YuriyKostyuchenko/FLOW_MONITOR_DUAL_INDEPENDENT_RELAYS_v6.4/FLOW_MONITOR_DUAL_INDEPENDENT_RELAYS/FLOW_MONITOR_DUAL_INDEPENDENT_RELAYS.pdf

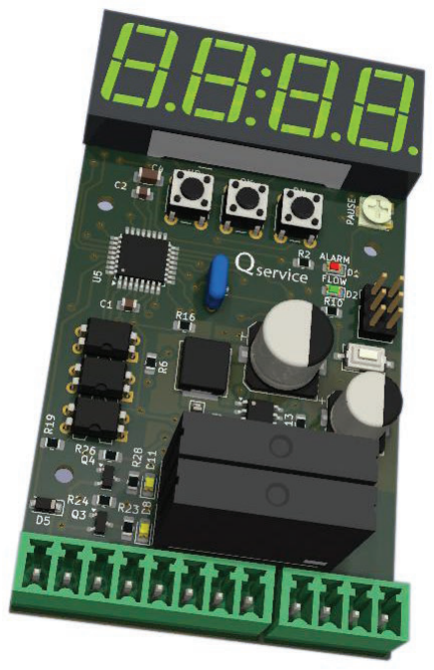
[picture p1: figure]

# FLOW MONITOR & DUAL INDEPENDENT RELAYS

v6.4

### Управление (Кнопки на приборе)

Кнопка | В рабочем режиме | В режиме меню
OK (удержание 2 сек) | Вход в сервисное меню | Выход в рабочий режим
OK (коротко) | Вход в параметр | Сохранение (надпись SAVE)
UP / DN | Выбор параметра | Изменение значения

### Таблица параметров (Меню)

Функция | Диапазон | Описание
P1 Калибровка | 0 — 9999 | Импульсов/литр. (значение из руководства датчика)
При 0 — вывод импульсов в сек.
P2 Мин. поток | 0 — 9999 | Порог срабатывания аварии.
При P1 = 0 количество импульсов. При P1 > 0 литров в минуту.
P3 Стабилизация | 1 — 255 сек | Время игнорирование потока
после подачи сигнала на EN.
P4 Режим (реле 1) | 0 — 4 | Алгоритм работы реле 1.
Режим 0: Прямой
Реле активно, пока на входе присутствует активный сигнал. Сигнал пропал — реле выключилось. Режим 1: Триггерный
Реле меняет состояние (ВКЛ/ВЫКЛ) по каждому переднему фронту сигнала (переход из 1 в 0). Режим 2: Одиночный импульс (Таймер)
При появлении сигнала реле включается на время А. Повторные сигналы во время работы игнорируются. Для перезапуска сигнал должен пропасть и появиться снова.
Режим 3: Цикл
Цикл «Работа А / Пауза Б» выполняется только при наличии активного сигнала на входе. Как только сигнал снимается реле мгновенно отключается,
а цикл сбрасывается.
Режим 4: Отложенный старт
При появлении сигнала запускается таймер паузы Б, после чего реле включается на время А.
Цикл отрабатывается полностью (one-shot), независимо от того, остался ли входной сигнал активным.
P5 Время А (реле 1) | 0 — 9999 сек | Время работы или основной интервал.
P6 Время B (реле 1) | 0 — 9999 сек | Время паузы или отложенного старта.
P7 Режим (реле 2) | 0 — 4 | Алгоритм работы реле 2.
Режим 0: Прямой
Реле активно, пока на входе присутствует активный сигнал. Сигнал пропал — реле выключилось. Режим 1: Триггерный
Реле меняет состояние (ВКЛ/ВЫКЛ) по каждому переднему фронту сигнала (переход из 1 в 0). Режим 2: Одиночный импульс (Таймер)
При появлении сигнала реле включается на время А. Повторные сигналы во время работы игнорируются.

Äëÿ ïåðåçàïóñêà ñèãíàë äîëæåí ïðîïàñòü è ïîÿâèòüñÿ ñíîâà.

### Ðåæèì 3: Öèêë

Öèêë «Ðàáîòà À / Ïàóçà Á» âûïîëíÿåòñÿ òîëüêî ïðè íàëè÷èè àêòèâíîãî ñèãíàëà íà âõîäå. Êàê òîëüêî ñèãíàë ñíèìàåòñÿ ðåëå ìãíîâåííî îòêëþ÷àåòñÿ,
à öèêë ñáðàñûâàåòñÿ.

### Ðåæèì 4: Îòëîæåííûé ñòàðò

Ïðè ïîÿâëåíèè ñèãíàëà çàïóñêàåòñÿ òàéìåð ïàóçû Á, ïîñëå ÷åãî ðåëå âêëþ÷àåòñÿ íà âðåìÿ À.
Öèêë îòðàáàòûâàåòñÿ ïîëíîñòüþ (one-shot), íåçàâèñèìî îò òîãî, îñòàëñÿ ëè âõîäíîé ñèãíàë àêòèâíûì.
P8 Âðåìÿ À (ðåëå 2) | 0 — 9999 ñåê | Âðåìÿ ðàáîòû èëè îñíîâíîé èíòåðâàë.
P9 Âðåìÿ B (ðåëå 1) | 0 — 9999 ñåê | Âðåìÿ ïàóçû èëè îòëîæåííîãî ñòàðòà.
P10 ßðêîñòü | 1 — 7 | Èíòåíñèâíîñòü ñâå÷åíèÿ äèñïëåÿ.

## Ëîãèêà ðàáîòû ðåëå (Âõîäû IN_1, IN_2)

Ñèãíàëû ñ÷èòàþòñÿ àêòèâíûìè ïðè ëîãè÷åñêîì «0» (çàìûêàíèå âõîäà íà GND).

### Ðåæèì 0: Ïðÿìîé

Ðåëå àêòèâíî, ïîêà íà âõîäå ïðèñóòñòâóåò àêòèâíûé ñèãíàë. Ñèãíàë ïðîïàë — ðåëå âûêëþ÷èëîñü.

### Ðåæèì 1: Òðèããåðíûé

Ðåëå ìåíÿåò ñîñòîÿíèå (ÂÊË/ÂÛÊË) ïî êàæäîìó ïåðåäíåìó ôðîíòó ñèãíàëà (ïåðåõîä èç 1 â 0).

### Ðåæèì 2: Îäèíî÷íûé èìïóëüñ (Òàéìåð)

Ïðè ïîÿâëåíèè ñèãíàëà ðåëå âêëþ÷àåòñÿ íà âðåìÿ À.
Ïîâòîðíûå ñèãíàëû âî âðåìÿ ðàáîòû èãíîðèðóþòñÿ.
Äëÿ ïåðåçàïóñêà ñèãíàë äîëæåí ïðîïàñòü è ïîÿâèòüñÿ ñíîâà.

### Ðåæèì 3: Öèêë

Öèêë «Ðàáîòà À / Ïàóçà Á» âûïîëíÿåòñÿ òîëüêî ïðè íàëè÷èè àêòèâíîãî ñèãíàëà íà âõîäå. Êàê òîëüêî CNC ñíèìàåò ñèãíàë, ðåëå ìãíîâåííî îòêëþ÷àåòñÿ, à öèêë ñáðàñûâàåòñÿ.

### Ðåæèì 4: Îòëîæåííûé ñòàðò

Ïðè ïîÿâëåíèè ñèãíàëà çàïóñêàåòñÿ òàéìåð ïàóçû Á, ïîñëå ÷åãî ðåëå âêëþ÷àåòñÿ íà âðåìÿ À. Öèêë îòðàáàòûâàåòñÿ ïîëíîñòüþ (one-shot), íåçàâèñèìî îò òîãî, îñòàëñÿ ëè âõîäíîé ñèãíàë àêòèâíûì.

## Êîíòðîëü ïîòîêà è Àâàðèÿ

Êîíòðîëü çàâÿçàí íà âõîä EN (ñèãíàë ãîòîâíîñòè ñèñòåìû èëè âêëþ÷åíèÿ øïèíäåëÿ/íàñîñà ñ CNC). Çàïóñê: ïðè ïîÿâëåíèè àêòèâíîãî ñèãíàëà íà EN.
Çàäåðæêà (P3): Îæèäàíèå âûõîäà ñèñòåìû íà ðàáî÷èé ðåæèì.
Ìîíèòîðèíã: åñëè ÷åðåç P3 ñåê ïîòîê íèæå P2:
Àêòèâèðóåòñÿ âûõîä ALARM_OUT (Ïèí A3).
Çàãîðàåòñÿ êðàñíûé LED, ãàñíåò çåëåíûé.
Ñáðîñ: ïðè ñíÿòèè ñèãíàëà ñ EN ñîñòîÿíèå àâàðèè ìãíîâåííî ñáðàñûâàåòñÿ.

## Ñîõðàíåíèå â ïàìÿòü (EEPROM)

×òîáû äàííûå íå îáíóëèëèñü:
Â ðåæèìå ðåäàêòèðîâàíèÿ óñòàíîâèòå çíà÷åíèå. Íàæìèòå êîðîòêî OK.
Äîæäèòåñü ïîÿâëåíèÿ íàäïèñè SAVE.
