YuriyKostyuchenko/FLOW_MONITOR_DUAL_INDEPENDENT_RELAYS_v6.4/FLOW_MONITOR_DUAL_INDEPENDENT_RELAYS/FLOW_MONITOR_DUAL_INDEPENDENT_RELAYS.kicad_pcb

## KiCad design FLOW_MONITOR_DUAL_INDEPENDENT_RELAYS/FLOW_MONITOR_DUAL_INDEPENDENT_RELAYS.kicad_pcb (2026-01-07)

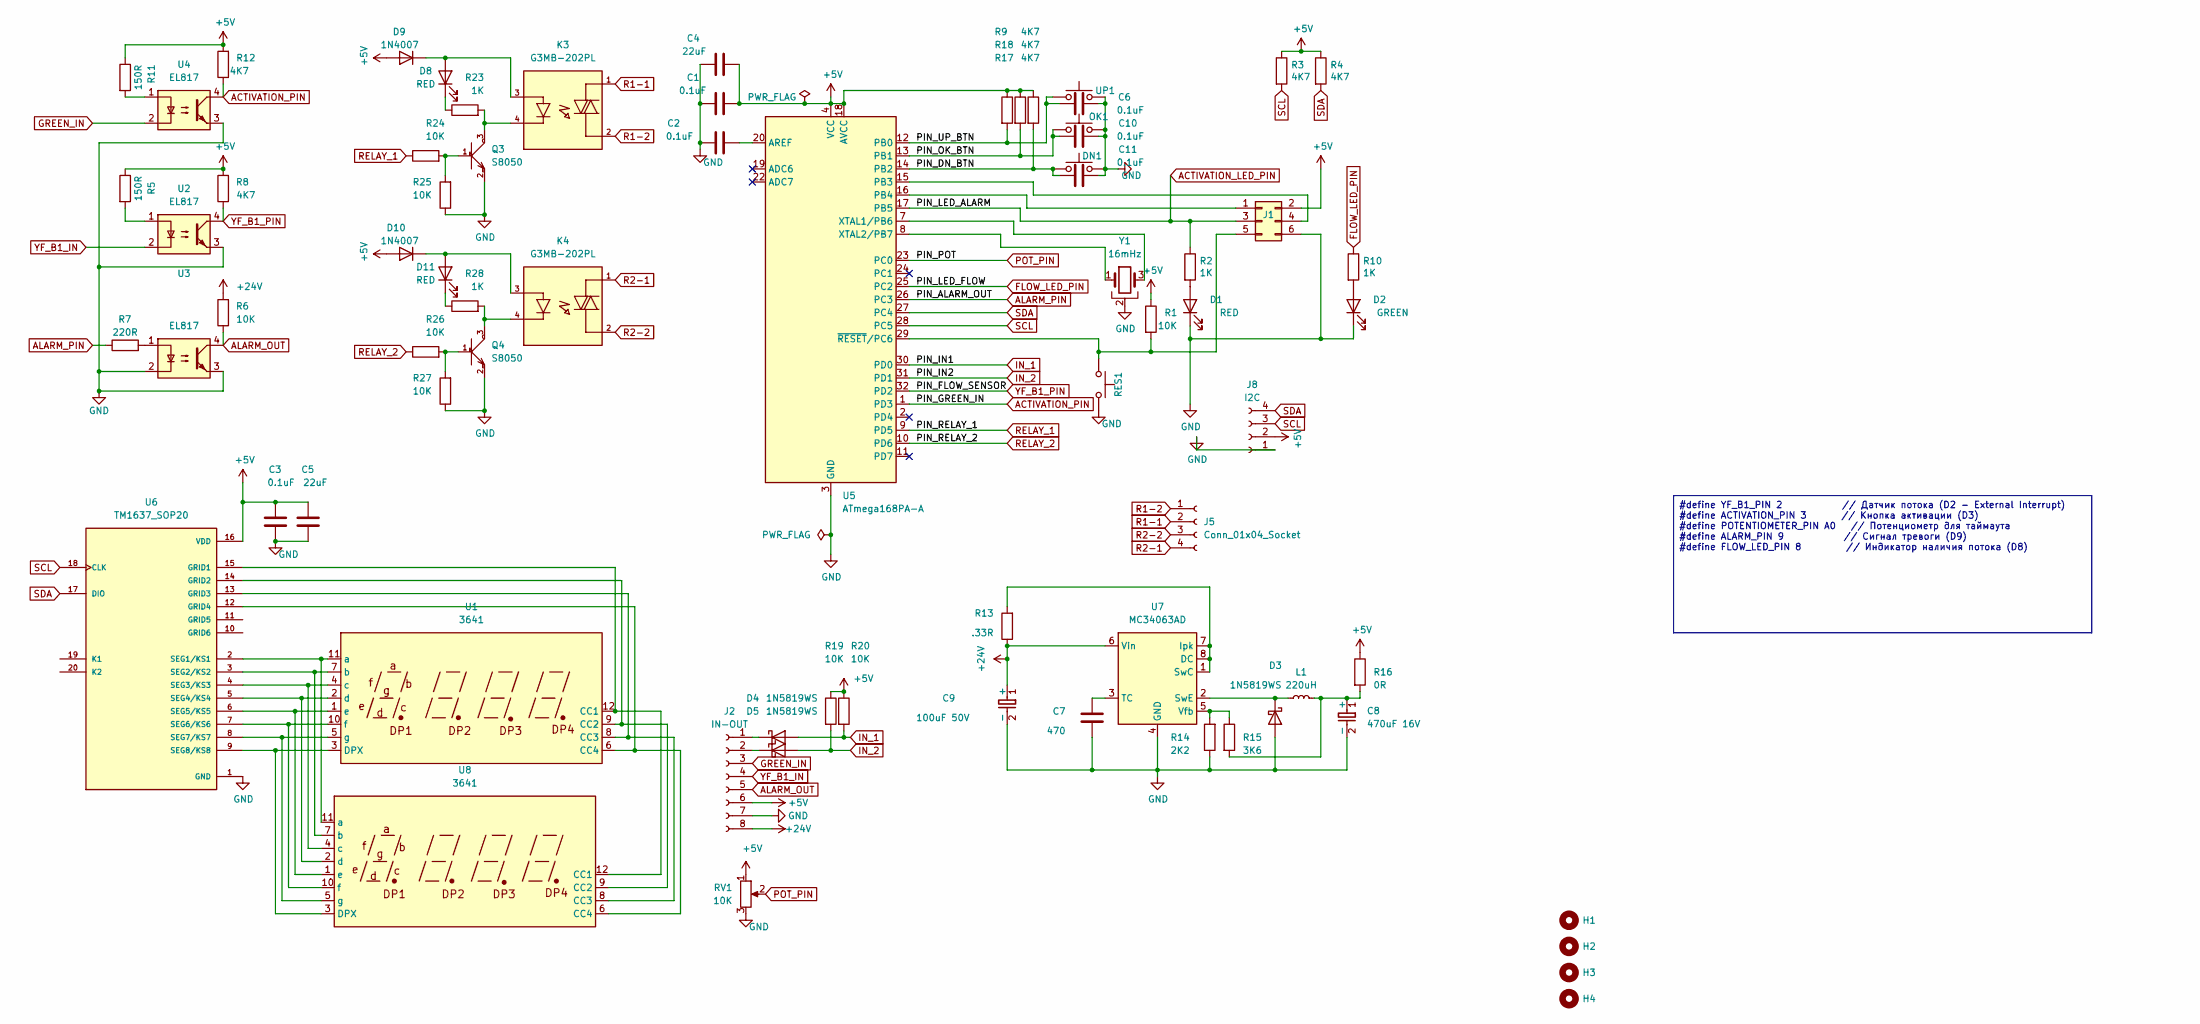
[picture p2: schematic FLOW_MONITOR_DUAL_INDEPENDENT_RELAYS.kicad_sch]

Parts:
C1, C2, C3, C6, C10, C11: 0.1uF; C_0805_2012Metric_Pad1.18x1.45mm_HandSolder
C4: 22uF; C_1206_3216Metric_Pad1.33x1.80mm_HandSolder
C5: 22uF; C_0805_2012Metric_Pad1.18x1.45mm_HandSolder
C7: 470; C_0805_2012Metric_Pad1.18x1.45mm_HandSolder
C8: 470uF 16V; CP_Elec_10x10.5
C9: 100uF 50V; CP_Elec_8x10
D1, D8, D11: RED; LED_0805_2012Metric_Pad1.15x1.40mm_HandSolder
D2: GREEN; LED_0805_2012Metric_Pad1.15x1.40mm_HandSolder
D3, D4, D5: 1N5819WS; D_SOD-123
D9, D10: 1N4007; D_SMA
DN1: SW_Push; SW_PUSH_6mm
H1, H2, H3, H4: MountingHole; MountingHole_2.5mm
J1: Conn_02x03_Top_Bottom; PinHeader_2x03_P2.54mm_Vertical
J2: IN-OUT; PhoenixContact_MCV_1,5_8-G-3.81_1x08_P3.81mm_Vertical
J5: Conn_01x04_Socket; PhoenixContact_MCV_1,5_4-G-3.81_1x04_P3.81mm_Vertical
J8: I2C; OLED_LCD_128x32
K3, K4: G3MB-202PL; RELAY_G3MB-202PL; PARTREV 06/09
L1: 220uH; L_7.3x7.3_!!!!!!!
OK1: SW_Push; SW_PUSH_6mm
Q3, Q4: S8050; SOT-23; MPN S8050
R1, R6, R19, R20, R24, R25, R26, R27: 10K; R_0805_2012Metric_Pad1.20x1.40mm_HandSolder
R2, R10, R23, R28: 1K; R_0805_2012Metric_Pad1.20x1.40mm_HandSolder
R3, R4, R8, R9, R12, R17, R18: 4K7; R_0805_2012Metric_Pad1.20x1.40mm_HandSolder
R5, R11: 150R; R_0805_2012Metric_Pad1.20x1.40mm_HandSolder
R7: 220R; R_0805_2012Metric_Pad1.20x1.40mm_HandSolder
R13: .33R; R_0805_2012Metric_Pad1.20x1.40mm_HandSolder
R14: 2K2; R_0805_2012Metric_Pad1.20x1.40mm_HandSolder
R15: 3K6; R_0805_2012Metric_Pad1.20x1.40mm_HandSolder
R16: 0R; R_0805_2012Metric_Pad1.20x1.40mm_HandSolder
RES1: SW_Push; SW_Tactile_SPST_NO_Straight_CK_PTS636Sx25SMTRLFS
RV1: 10K; Potentiometer_Bourns_3314J_Vertical
U1: 3641; 3631
U2, U3, U4: EL817; DIP-4_W7.62mm
U5: ATmega168PA-A; TQFP-32_7x7mm_P0.8mm
U6: TM1637_SOP20; SOIC127P1035X255-20N; PARTREV V2.6
U7: MC34063AD; SOIC-8_3.9x4.9mm_P1.27mm
U8: 3641; CC56-12GWA
UP1: SW_Push; SW_PUSH_6mm
Y1: 16mHz; XTAL_ZTT-4.00MG

Connections:
+5V: C1.2, C3.2, C4.2, C5.2, D9.2 (A), D10.2 (A), J1.2, J2.6, J8.2, R1.1, R3.1, R4.1, R5.1, R8.2, R9.1, R11.1, R12.2, R16.1, R17.1, R18.1, R19.1, R20.1, RV1.1, U5.4 (VCC), U5.6 (VCC), U5.18 (AVCC), U6.16 (VDD)
+24V: C9.1 (+), J2.8, R6.2, R13.1, U7.6 (Vin)
ACTIVATION_LED_PIN: J1.3, R2.1, U5.17 (PB5)
ACTIVATION_PIN: R12.1, U4.4, U5.1 (PD3)
ALARM_OUT: J2.5, R6.1, U3.4
ALARM_PIN: R7.1, U5.26 (PC3)
FLOW_LED_PIN: R10.1, U5.25 (PC2)
GND: C1.1, C2.1, C3.1, C4.1, C5.1, C6.2, C7.1, C8.2 (-), C9.2 (-), C10.2, C11.2, D1.1 (K), D2.1 (K), D3.2 (A), DN1.2, J1.6, J2.7, J8.1, OK1.2, Q3.2, Q4.2, R14.1, R25.1, R27.1, RES1.2, RV1.3, U2.3, U3.2, U3.3, U4.3, U5.3 (GND), U5.5 (GND), U5.21 (GND), U6.1 (GND), U7.4 (GND), UP1.2, Y1.2
GREEN_IN: J2.3, U4.2
IN_1: D4.2 (A), R20.2, U5.30 (PD0)
IN_2: D5.2 (A), R19.2, U5.31 (PD1)
unnamed: C8.1 (+), L1.2, R15.2, R16.2
unnamed: D1.2 (A), R2.2
unnamed: D2.2 (A), R10.2
unnamed: D3.1 (K), L1.1, U7.2 (SwE)
unnamed: D4.1 (K), J2.1
unnamed: D5.1 (K), J2.2
unnamed: D8.2 (A), D9.1 (K), K3.3
unnamed: D8.1 (K), R23.1
unnamed: D10.1 (K), D11.2 (A), K4.3
unnamed: D11.1 (K), R28.1
unnamed: J1.1, U5.16 (PB4)
unnamed: J1.4, U5.15 (PB3)
unnamed: J1.5, R1.2, RES1.1, U5.29 (~RESET/PC6)
unnamed: K3.4, Q3.3, R23.2
unnamed: K4.4, Q4.3, R28.2
unnamed: Q3.1, R24.2, R25.2
unnamed: Q4.1, R26.2, R27.2
unnamed: R5.2, U2.1
unnamed: R7.2, U3.1
unnamed: R11.2, U4.1
unnamed: U1.12 (CC1), U6.15 (GRID1), U8.12 (CC1)
unnamed: U1.9 (CC2), U6.14 (GRID2), U8.9 (CC2)
unnamed: U1.8 (CC3), U6.13 (GRID3), U8.8 (CC3)
unnamed: U1.6 (CC4), U6.12 (GRID4), U8.6 (CC4)
unnamed: U1.3 (DPX), U6.9 (SEG8/KS8), U8.3 (DPX)
unnamed: U1.11 (a), U6.2 (SEG1/KS1), U8.11 (a)
unnamed: U1.7 (b), U6.3 (SEG2/KS2), U8.7 (b)
unnamed: U1.4 (c), U6.4 (SEG3/KS3), U8.4 (c)
unnamed: U1.2 (d), U6.5 (SEG4/KS4), U8.2 (d)
unnamed: U1.1 (e), U6.6 (SEG5/KS5), U8.1 (e)
unnamed: U1.10 (f), U6.7 (SEG6/KS6), U8.10 (f)
unnamed: U1.5 (g), U6.8 (SEG7/KS7), U8.5 (g)
unnamed: C2.2, U5.20 (AREF)
unnamed: C6.1, R9.2, U5.12 (PB0), UP1.1
unnamed: C10.1, OK1.1, R17.2, U5.13 (PB1)
unnamed: C11.1, DN1.1, R18.2, U5.14 (PB2)
unnamed: U5.7 (XTAL1/PB6), Y1.3
unnamed: U5.8 (XTAL2/PB7), Y1.1
unnamed: R13.2, U7.1 (SwC), U7.7 (Ipk), U7.8 (DC)
unnamed: C7.2, U7.3 (TC)
unnamed: R14.2, R15.1, U7.5 (Vfb)
POT_PIN: RV1.2, U5.23 (PC0)
R1-1: J5.2, K3.1
R1-2: J5.1, K3.2
R2-1: J5.4, K4.1
R2-2: J5.3, K4.2
RELAY_1: R24.1, U5.9 (PD5)
RELAY_2: R26.1, U5.10 (PD6)
SCL: J8.3, R3.2, U5.28 (PC5), U6.18 (CLK)
SDA: J8.4, R4.2, U5.27 (PC4), U6.17 (DIO)
YF_B1_IN: J2.4, U2.2
YF_B1_PIN: R8.1, U2.4, U5.32 (PD2)

Notes on the sheet:
#define YF_B1_PIN 2 // Датчик потока (D2 - External Interrupt) #define ACTIVATION_PIN 3 // Кнопка активации (D3) #define POTENTIOMETER_PIN A0 // Потенциометр для таймаута #define ALARM_PIN 9 // Сигнал тревоги (D9) #define FLOW_LED_PIN 8 // Индикатор наличия потока (D8)

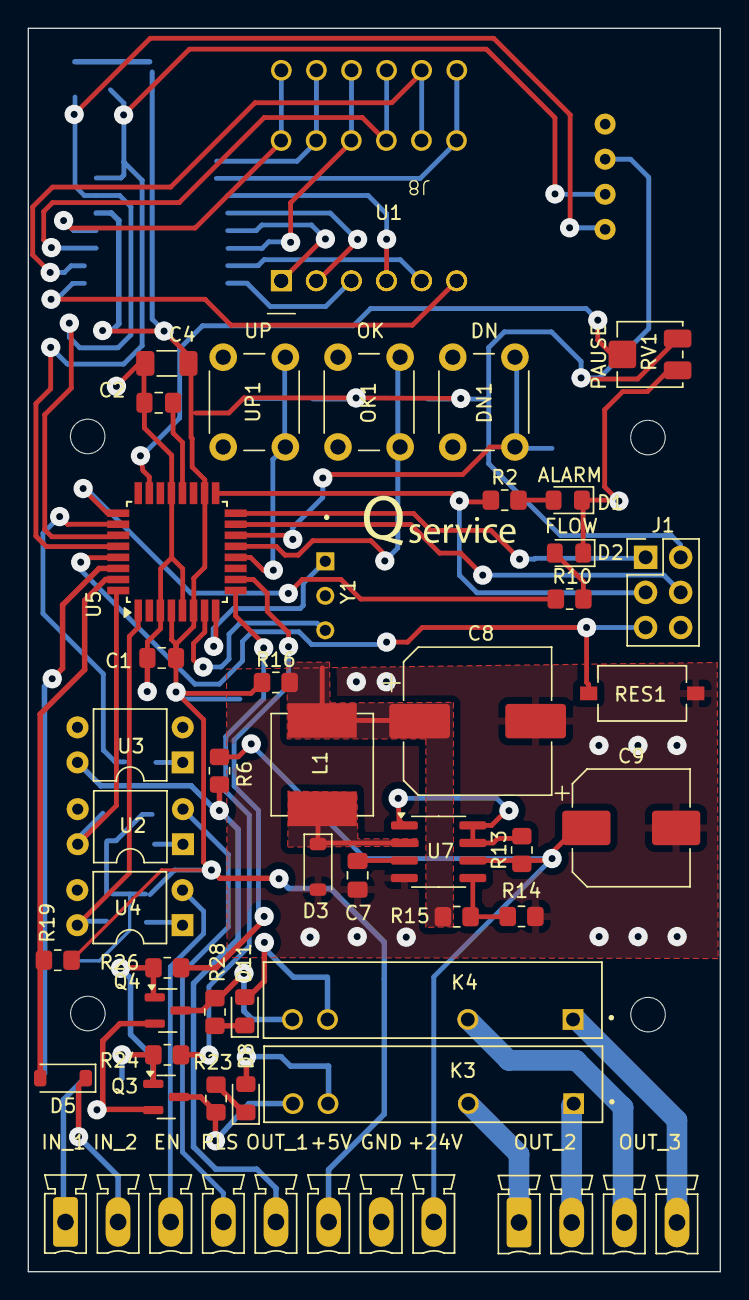
[picture p3: board FLOW_MONITOR_DUAL_INDEPENDENT_RELAYS.kicad_pcb from above]

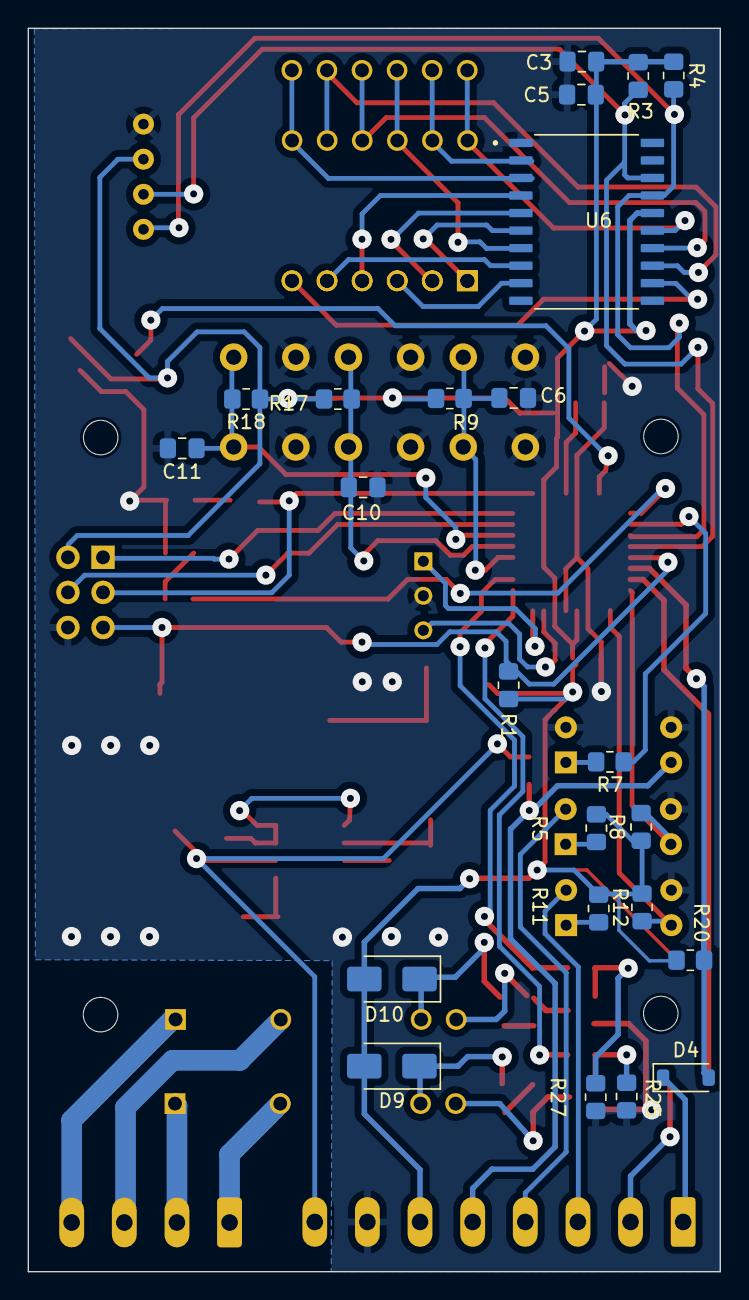
[picture p4: board FLOW_MONITOR_DUAL_INDEPENDENT_RELAYS.kicad_pcb from below]

Board: 2 copper layers, 50.1 x 90.0 mm, 73 parts (23 on the bottom side), 63 nets.
